iRobotics-Pacbot/Electrical/README.md

View this project on [CADLAB.io](https://cadlab.io/project/28443). 

# Electrical
