iRobotics-Pacbot/Electrical/power2025/MainPCB/Added Parts/NCP167BMX330TBG/NCP167BMX330TBG.step

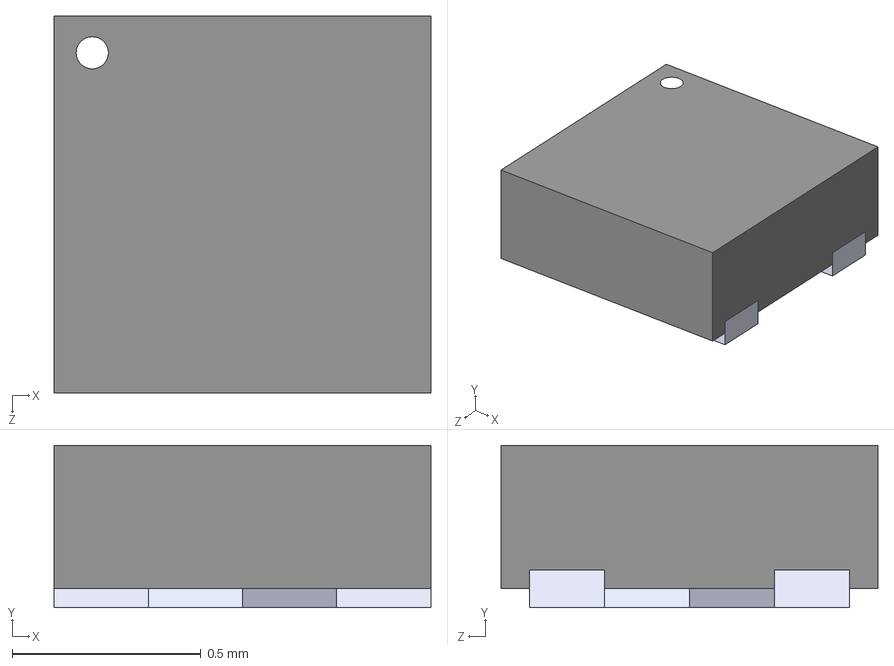
[picture p1: CAD file, 2025-10-03]
power2025/MainPCB/Added Parts/NCP167BMX330TBG/NCP167BMX330TBG.step
1.00 x 0.43 x 1.00 mm
