iRobotics-Pacbot/Electrical/power2025/MainPCB/MainPCB.kicad_pcb

## KiCad design power2025/MainPCB/MainPCB.kicad_pcb (2025-10-12)

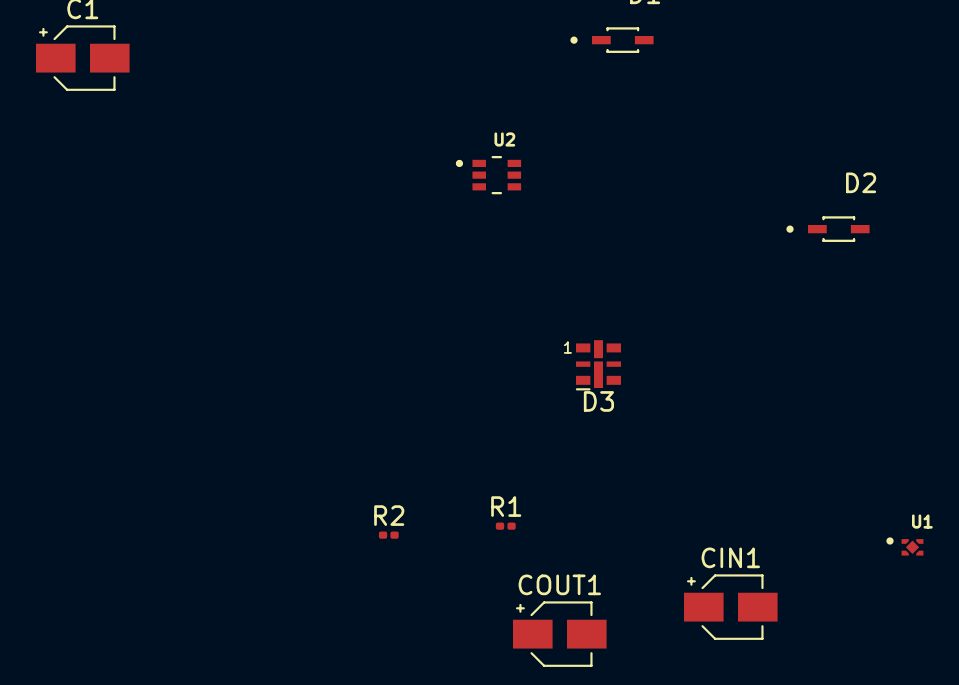
[picture p2: board MainPCB.kicad_pcb from above]

Board: 2 copper layers, 10 parts (0 on the bottom side), 5 nets, no tracks yet.

Parts:
C1: 10uF; CP_Elec_3x5.3
CIN1: 1uF; CP_Elec_3x5.3
COUT1: 1uF; CP_Elec_3x5.3
D1, D2: D_Schottky_Filled; SOD2513X120N
D3: RED; LED-APA102-2020
R1: 100K; R_0201_0603Metric
R2: 3K3; R_0201_0603Metric
U1: NCP167BMX330TBG; VREG_NCP167BMX330TBG
U2: CJ3139K; SOP65P210X110-6N

Connections:
GND: C1.1, CIN1.2, COUT1.2, D3.1 (K), R1.1, U1.2 (GND), U1.5 (EPAD)
unnamed: C1.2, D1.1 (K), D2.2 (A), R1.2, R2.2
unnamed: CIN1.1, D2.1 (K), U1.3 (EN), U1.4 (IN)
unnamed: D3.2 (A), R2.1
unnamed: COUT1.1, U1.1 (OUT)
