iRobotics-Pacbot/Electrical/Pacbot_example/pacbot_example.kicad_pcb

## KiCad design Pacbot_example/pacbot_example.kicad_pcb (2025-09-28)

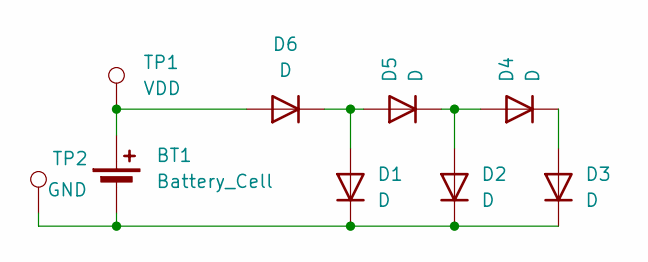
[picture p3: schematic pacbot_example.kicad_sch]

Parts:
BT1: Battery_Cell; BatteryHolder_LINX_BAT-HLD-012-SMT
D1, D2, D3, D4, D5, D6: D; D_0805_2012Metric
TP1: VDD; PinHeader_1x01_P2.54mm_Vertical
TP2: GND; PinHeader_1x01_P2.54mm_Vertical

Connections:
unnamed: BT1.1 (+), D6.2 (A), TP1.1
unnamed: BT1.2 (-), D1.1 (K), D2.1 (K), D3.1 (K), TP2.1
unnamed: D1.2 (A), D5.2 (A), D6.1 (K)
unnamed: D2.2 (A), D4.2 (A), D5.1 (K)
unnamed: D3.2 (A), D4.1 (K)

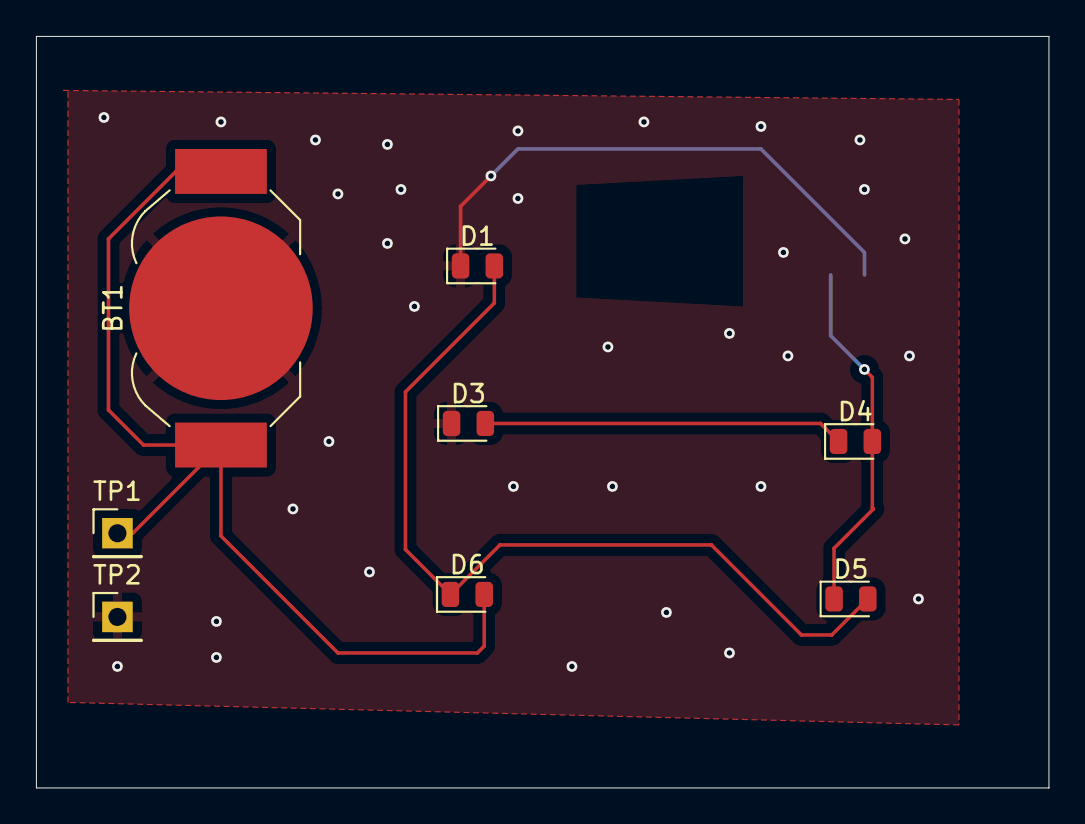
[picture p4: board pacbot_example.kicad_pcb from above]

Board: 2 copper layers, 56.2 x 41.8 mm, 9 parts (1 on the bottom side), 5 nets.
