iRobotics-Pacbot/Electrical/pacboard2025_alt/pacboard2025_alt.kicad_pcb

## KiCad design pacboard2025_alt/pacboard2025_alt.kicad_pcb (2025-02-01)

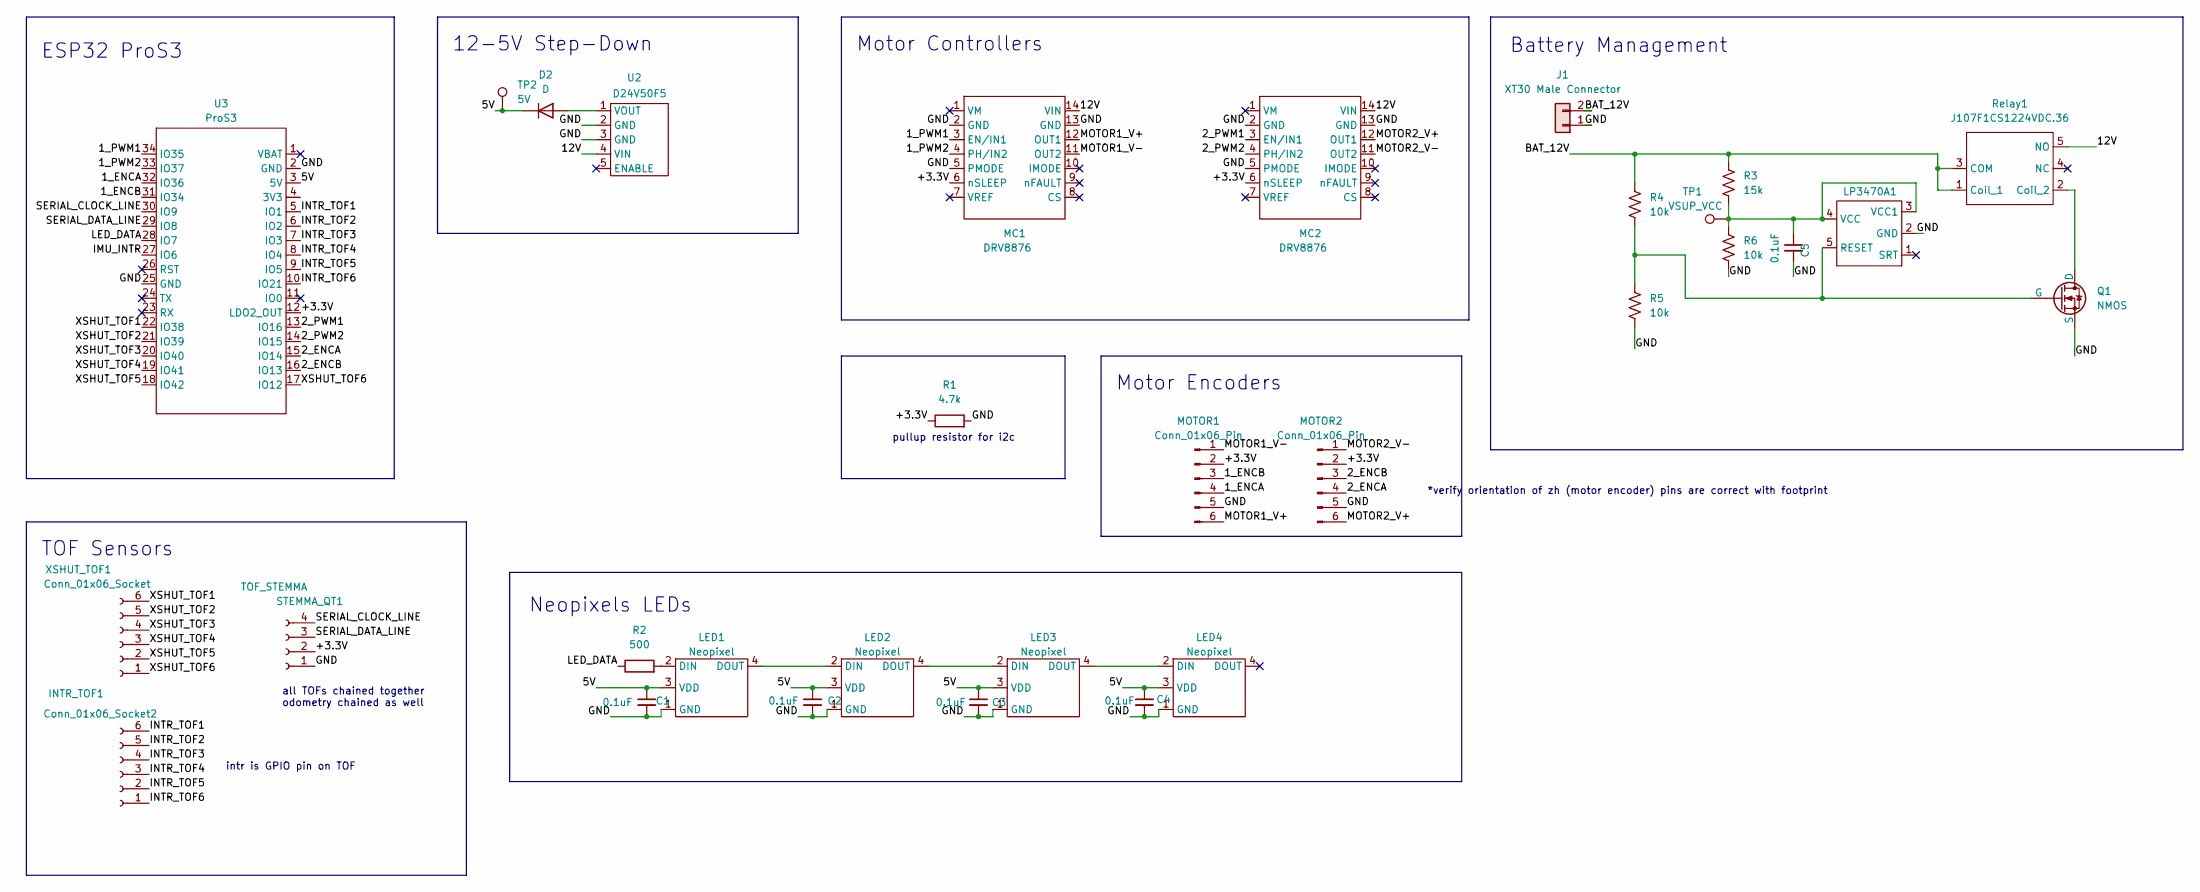
[picture p5: schematic pacboard2025_alt.kicad_sch]

Parts:
C1, C2, C3, C4, C5: 0.1uF; C_0805_2012Metric_Pad1.18x1.45mm_HandSolder
D2: D; D_SMB
INTR_TOF1: Conn_01x06_Socket2; PinHeader_1x06_P2.54mm_Vertical
J1: XT30 Male Connector; AMASS_XT30U-M_1x02_P5.0mm_Vertical
LED1, LED2, LED3, LED4: Neopixel; Neopixels 5050
LP3470A1: SOT-23-5
MC1, MC2: DRV8876
MOTOR1, MOTOR2: Conn_01x06_Pin; ZH1.5-6
Q1: NMOS; SOT-23
R1: 4.7k; R_0805_2012Metric_Pad1.20x1.40mm_HandSolder
R2: 500; R_0805_2012Metric_Pad1.20x1.40mm_HandSolder
R3: 15k; R_0805_2012Metric
R4, R5, R6: 10k; R_0805_2012Metric
Relay1: J107F1CS1224VDC.36; J107
STEMMA_QT1: TOF_STEMMA; JST_SH_SM04B-SRSS-TB_1x04-1MP_P1.00mm_Horizontal
TP1: VSUP_VCC; PinHeader_1x01_P2.54mm_Vertical
TP2: 5V; PinHeader_1x01_P2.54mm_Vertical
U2: D24V50F5; PinHeader_1x05_P2.54mm_Vertical
U3: ProS3; ProS3_TH (1)
XSHUT_TOF1: Conn_01x06_Socket; PinHeader_1x06_P2.54mm_Vertical

Connections:
/1_ENCA: MOTOR1.4, U3.32 (IO36)
/1_ENCB: MOTOR1.3, U3.31 (IO34)
/1_PWM1: MC1.3 (EN/IN1), U3.34 (IO35)
/1_PWM2: MC1.4 (PH/IN2), U3.33 (IO37)
/2_ENCA: MOTOR2.4, U3.15 (IO14)
/2_ENCB: MOTOR2.3, U3.16 (IO13)
/2_PWM1: MC2.3 (EN/IN1), U3.13 (IO16)
/2_PWM2: MC2.4 (PH/IN2), U3.14 (IO15)
/5V: C1.1, C2.1, C3.1, C4.1, D2.1 (K), LED1.3 (VDD), LED2.3 (VDD), LED3.3 (VDD), LED4.3 (VDD), TP2.1, U3.3 (5V)
/12V: MC1.14 (VIN), MC2.14 (VIN), Relay1.5 (NO), U2.4 (VIN)
/+3.3V: MC1.6 (nSLEEP), MC2.6 (nSLEEP), MOTOR1.2, MOTOR2.2, R1.1, STEMMA_QT1.2, U3.12 (LDO2_OUT)
/BAT_12V: J1.2, R3.1, R4.1, Relay1.1 (Coil_1), Relay1.3 (COM)
/GND: C1.2, C2.2, C3.2, C4.2, C5.2, J1.1, LED1.1 (GND), LED2.1 (GND), LED3.1 (GND), LED4.1 (GND), LP3470A1.2 (GND), MC1.2 (GND), MC1.5 (PMODE), MC1.13 (GND), MC2.2 (GND), MC2.5 (PMODE), MC2.13 (GND), MOTOR1.5, MOTOR2.5, Q1.2 (S), R1.2, R5.2, R6.2, STEMMA_QT1.1, U2.2 (GND), U2.3 (GND), U3.2 (GND), U3.25 (GND); also elsewhere on the board
/IMU_INTR: U3.27 (IO6)
/INTR_TOF1: INTR_TOF1.6, U3.5 (IO1)
/INTR_TOF2: INTR_TOF1.5, U3.6 (IO2)
/INTR_TOF3: INTR_TOF1.4, U3.7 (IO3)
/INTR_TOF4: INTR_TOF1.3, U3.8 (IO4)
/INTR_TOF5: INTR_TOF1.2, U3.9 (IO5)
/INTR_TOF6: INTR_TOF1.1, U3.10 (IO21)
/LED_DATA: R2.1, U3.28 (IO7)
/MOTOR1_V+: MC1.12 (OUT1), MOTOR1.6
/MOTOR1_V-: MC1.11 (OUT2), MOTOR1.1
/MOTOR2_V+: MC2.12 (OUT1), MOTOR2.6
/MOTOR2_V-: MC2.11 (OUT2), MOTOR2.1
/SERIAL_CLOCK_LINE: STEMMA_QT1.4, U3.30 (IO9)
/SERIAL_DATA_LINE: STEMMA_QT1.3, U3.29 (IO8)
/XSHUT_TOF1: U3.22 (IO38), XSHUT_TOF1.6
/XSHUT_TOF2: U3.21 (IO39), XSHUT_TOF1.5
/XSHUT_TOF3: U3.20 (IO40), XSHUT_TOF1.4
/XSHUT_TOF4: U3.19 (IO41), XSHUT_TOF1.3
/XSHUT_TOF5: U3.18 (IO42), XSHUT_TOF1.2
/XSHUT_TOF6: U3.17 (IO12), XSHUT_TOF1.1
unnamed: D2.2 (A), U2.1 (VOUT)
unnamed: LED1.2 (DIN), R2.2
unnamed: LED1.4 (DOUT), LED2.2 (DIN)
unnamed: LED2.4 (DOUT), LED3.2 (DIN)
unnamed: LED3.4 (DOUT), LED4.2 (DIN)
unnamed: LP3470A1.5 (RESET), Q1.1 (G), R4.2, R5.1
unnamed: C5.1, LP3470A1.3 (VCC1), LP3470A1.4 (VCC), R3.2, R6.1, TP1.1
unnamed: Q1.3 (D), Relay1.2 (Coil_2)

Notes on the sheet:
ESP32 ProS3
pullup resistor for i2c
intr is GPIO pin on TOF
Motor Encoders
all TOFs chained together odometry chained as well
12-5V Step-Down
Battery Management
*verify orientation of zh (motor encoder) pins are correct with footprint
TOF Sensors
Motor Controllers
Neopixels LEDs

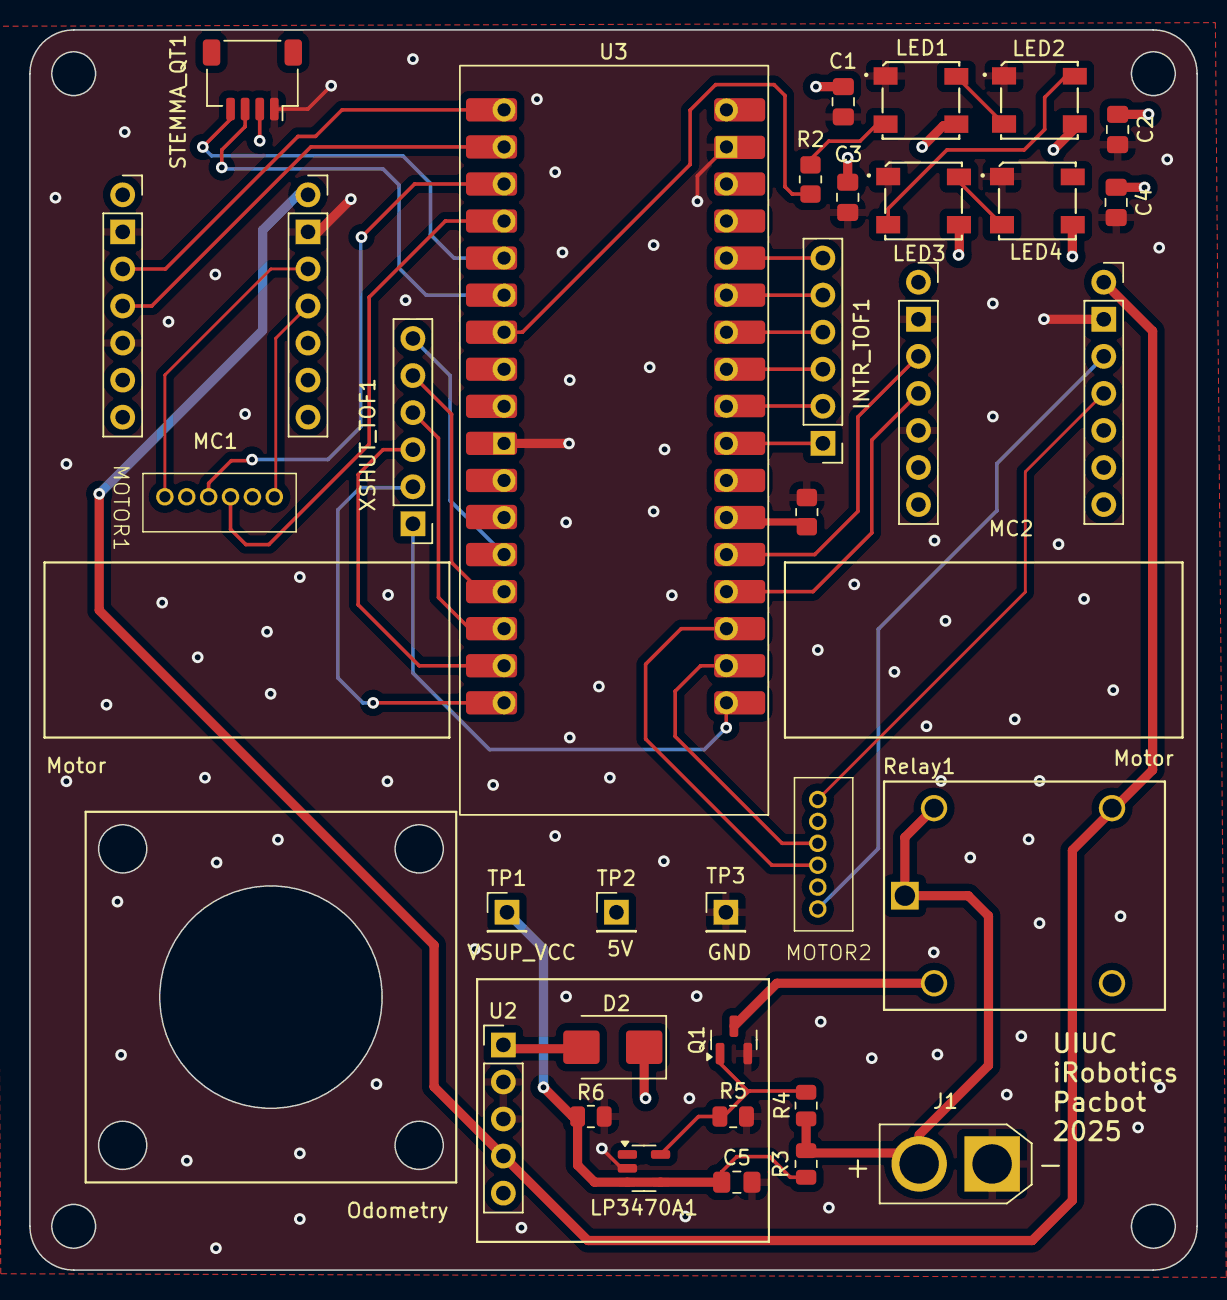
[picture p6: board pacboard2025_alt.kicad_pcb from above]

Board: 4 copper layers, 80.0 x 85.0 mm, 32 parts (0 on the bottom side), 40 nets.

Other parts of the board:
TP3: GND; PinHeader_1x01_P2.54mm_Vertical

Their connections:
/GND: TP3.1; also elsewhere on the board
