iRobotics-Pacbot/Electrical/pacboard2023/board1.kicad_pcb

## KiCad design pacboard2023/board1.kicad_pcb (2024-09-14)

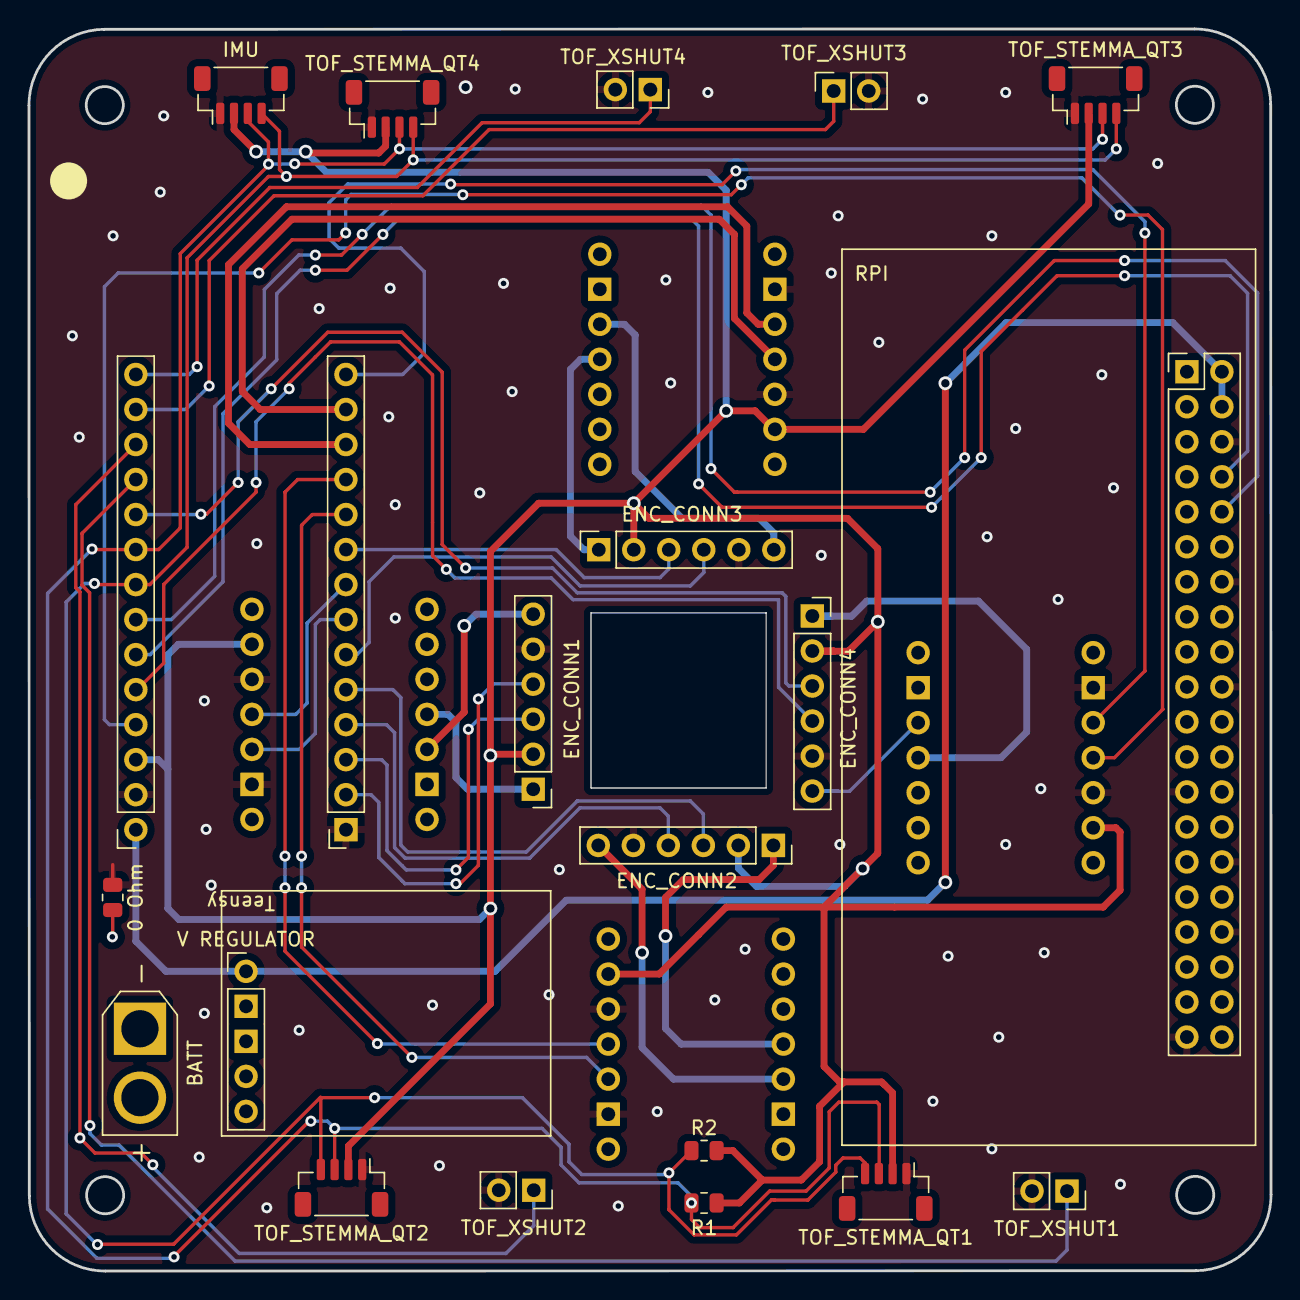
[picture p7: board pacboard2023/board1.kicad_pcb from above]

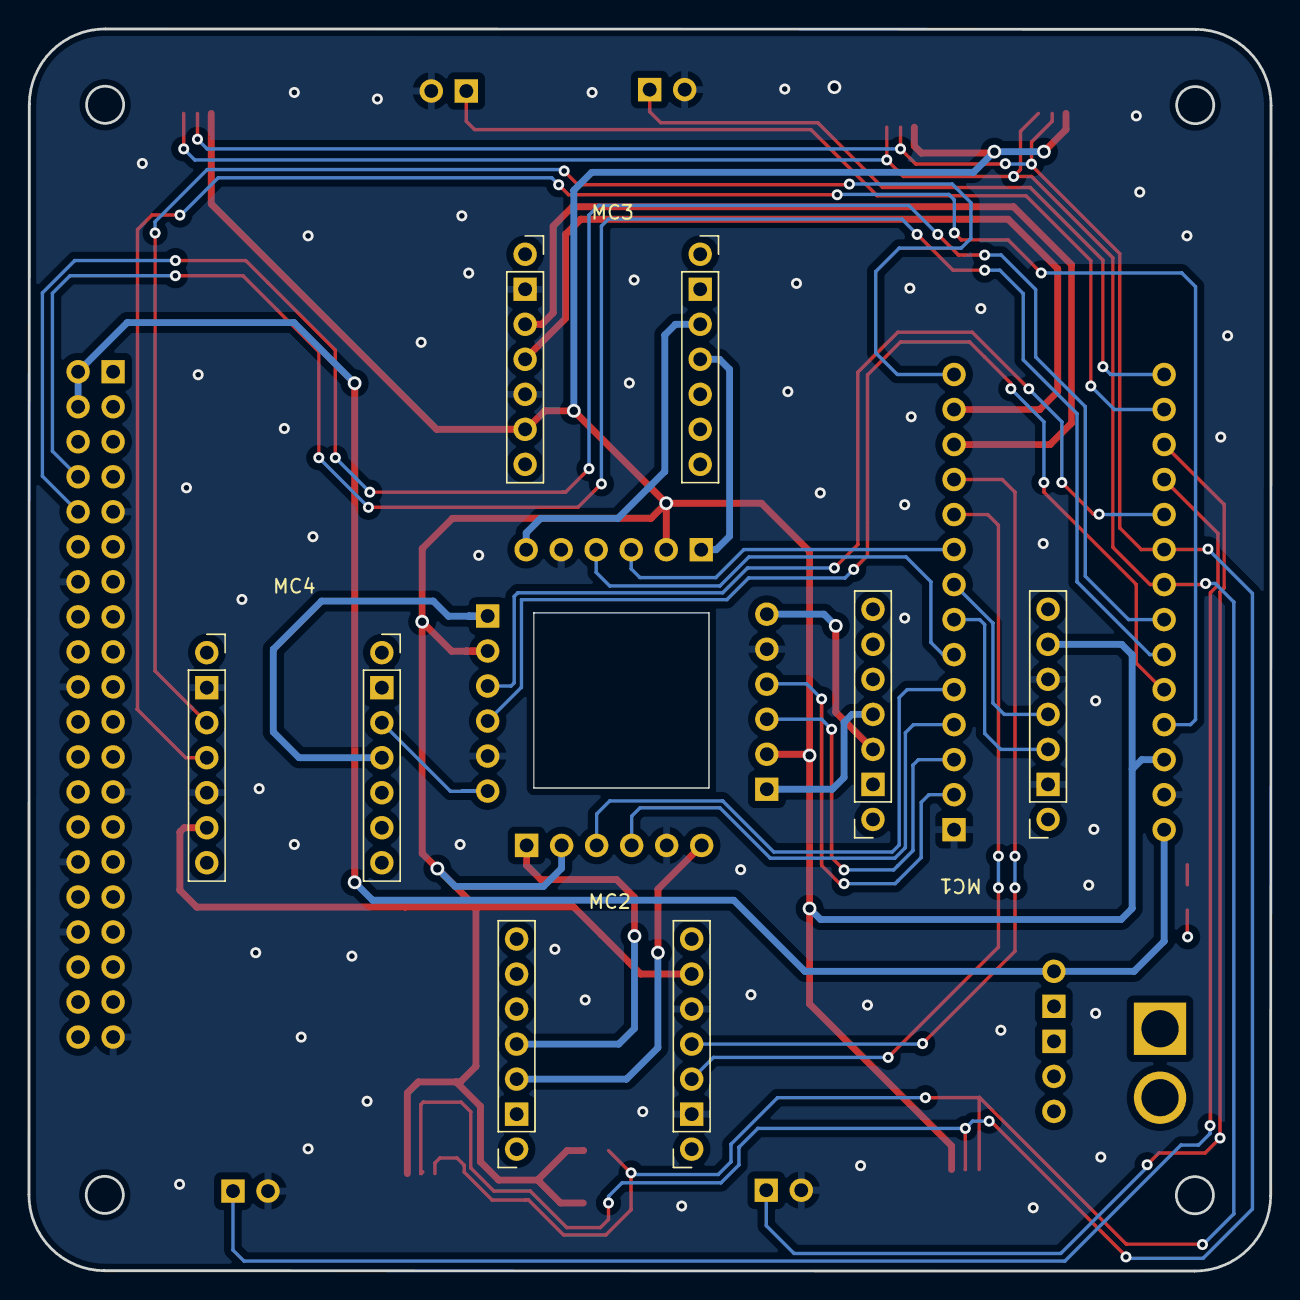
[picture p8: board pacboard2023/board1.kicad_pcb from below]

Board: 4 copper layers, 90.1 x 90.1 mm, 24 parts (4 on the bottom side), 37 nets.

Parts:
0 Ohm: 0 Ohms; R_0805_2012Metric
BATT: XT30 Male Connector; AMASS_XT30U-M_1x02_P5.0mm_Vertical
ENC_CONN1: Conn_01x06_Male; PinHeader_1x06_P2.54mm_Vertical
ENC_CONN2, ENC_CONN3, ENC_CONN4: Conn_01x06_Male; PinSocket_1x06_P2.54mm_Vertical
IMU: BNO085; JST_SH_BM04B-SRSS-TB_1x04-1MP_P1.00mm_Vertical
MC1, MC2, MC3, MC4: DRV8876
R1, R2: 4.7k; R_0805_2012Metric
RPI: Raspberry_PI_Zero_W; Raspberry Pi Zero W
TOF_STEMMA_QT1, TOF_STEMMA_QT2, TOF_STEMMA_QT3, TOF_STEMMA_QT4: Conn_01x04_Female; JST_SH_BM04B-SRSS-TB_1x04-1MP_P1.00mm_Vertical
TOF_XSHUT1, TOF_XSHUT2, TOF_XSHUT3, TOF_XSHUT4: Conn_01x02_Female; PinSocket_1x02_P2.54mm_Vertical
Teensy: Teensy_4.0; Teensy 4.0
V REGULATOR: D24V50F5; Voltage Regulator D24V50F5

Connections:
/3V3_Teensy: ENC_CONN1.2, ENC_CONN2.2, ENC_CONN3.2, ENC_CONN4.2, IMU.2 (VIN), MC1.6 (nSLEEP), MC2.6 (nSLEEP), MC3.6 (nSLEEP), MC4.6 (nSLEEP), R1.2, R2.2, TOF_STEMMA_QT1.2, TOF_STEMMA_QT2.2, TOF_STEMMA_QT3.2, TOF_STEMMA_QT4.2, Teensy.6 (3.3V)
/5V: RPI.2 (5V), RPI.4 (5V), Teensy.2 (Vin), V REGULATOR.1 (VOUT)
/12V: BATT.2, MC1.14 (VIN), MC2.14 (VIN), MC3.14 (VIN), MC4.14 (VIN), V REGULATOR.4 (VIN)
/BATTERY_GROUND: 0 Ohm.2, BATT.1, MC1.13 (GND), MC2.13 (GND), MC3.13 (GND), MC4.13 (GND), V REGULATOR.2 (GND), V REGULATOR.3 (GND)
/ENC_1_PINA: ENC_CONN1.4, Teensy.3 (0)
/ENC_1_PINB: ENC_CONN1.3, Teensy.5 (1)
/ENC_2_PINA: ENC_CONN2.4, Teensy.7 (2)
/ENC_2_PINB: ENC_CONN2.3, Teensy.9 (3)
/ENC_3_PINA: ENC_CONN3.4, Teensy.11 (4)
/ENC_3_PINB: ENC_CONN3.3, Teensy.17 (7)
/ENC_4_PINA: ENC_CONN4.4, Teensy.10 (22)
/ENC_4_PINB: ENC_CONN4.3, Teensy.20 (17)
/MC1_PWM1: MC1.3 (EN/IN1), Teensy.13 (5)
/MC1_PWM2: MC1.4 (PH/IN2), Teensy.15 (6)
/MC2_PWM1: MC2.3 (EN/IN1), Teensy.19 (8)
/MC2_PWM2: MC2.4 (PH/IN2), Teensy.21 (9)
/MC3_PWM1: MC3.3 (EN/IN1), Teensy.23 (10)
/MC3_PWM2: MC3.4 (PH/IN2), Teensy.25 (11)
/MC4_PWM1: MC4.3 (EN/IN1), Teensy.27 (12)
/MC4_PWM2: MC4.4 (PH/IN2), Teensy.8 (23)
/MOTOR_1_PIN1: ENC_CONN1.6, MC1.12 (OUT1)
/MOTOR_1_PIN2: ENC_CONN1.1, MC1.11 (OUT2)
/MOTOR_2_PIN1: ENC_CONN2.6, MC2.12 (OUT1)
/MOTOR_2_PIN2: ENC_CONN2.1, MC2.11 (OUT2)
/MOTOR_3_PIN1: ENC_CONN3.6, MC3.12 (OUT1)
/MOTOR_3_PIN2: ENC_CONN3.1, MC3.11 (OUT2)
/MOTOR_4_PIN1: ENC_CONN4.6, MC4.12 (OUT1)
/MOTOR_4_PIN2: ENC_CONN4.1, MC4.11 (OUT2)
/SCL_LINE: IMU.4 (SCL), R2.1, TOF_STEMMA_QT1.4, TOF_STEMMA_QT2.4, TOF_STEMMA_QT3.4, TOF_STEMMA_QT4.4, Teensy.16 (19)
/SDA_LINE: IMU.3 (SDA), R1.1, TOF_STEMMA_QT1.3, TOF_STEMMA_QT2.3, TOF_STEMMA_QT3.3, TOF_STEMMA_QT4.3, Teensy.18
/TOF_1_XSHUT: TOF_XSHUT1.1, Teensy.22 (16)
/TOF_2_XSHUT: TOF_XSHUT2.1, Teensy.24 (15)
/TOF_3_XSHUT: TOF_XSHUT3.1, Teensy.26 (14)
/TOF_4_XSHUT: TOF_XSHUT4.1, Teensy.28 (13)
/UART RXD (R PI): RPI.10 (GPIO_15_(RXD)), Teensy.14 (20)
/UART TXD (R PI): RPI.8 (GPIO_14_(TXD)), Teensy.12 (21)
GNDREF: 0 Ohm.1, ENC_CONN1.5, ENC_CONN2.5, ENC_CONN3.5, ENC_CONN4.5, IMU.1 (GND), MC1.2 (GND), MC1.5 (PMODE), MC2.2 (GND), MC2.5 (PMODE), MC3.2 (GND), MC3.5 (PMODE), MC4.2 (GND), MC4.5 (PMODE), RPI.6 (GND), RPI.9 (GND), RPI.14 (GND), RPI.20 (GND), RPI.25 (GND), RPI.30 (GND), RPI.34 (GND), RPI.39 (GND), TOF_STEMMA_QT1.1, TOF_STEMMA_QT2.1, TOF_STEMMA_QT3.1, TOF_STEMMA_QT4.1, TOF_XSHUT1.2, TOF_XSHUT2.2, TOF_XSHUT3.2, TOF_XSHUT4.2, Teensy.1 (GND), Teensy.4 (GND)
