iRobotics-Pacbot/Electrical/pacboard2024/board1.kicad_pcb

## KiCad design pacboard2024/board1.kicad_pcb (2024-09-14)

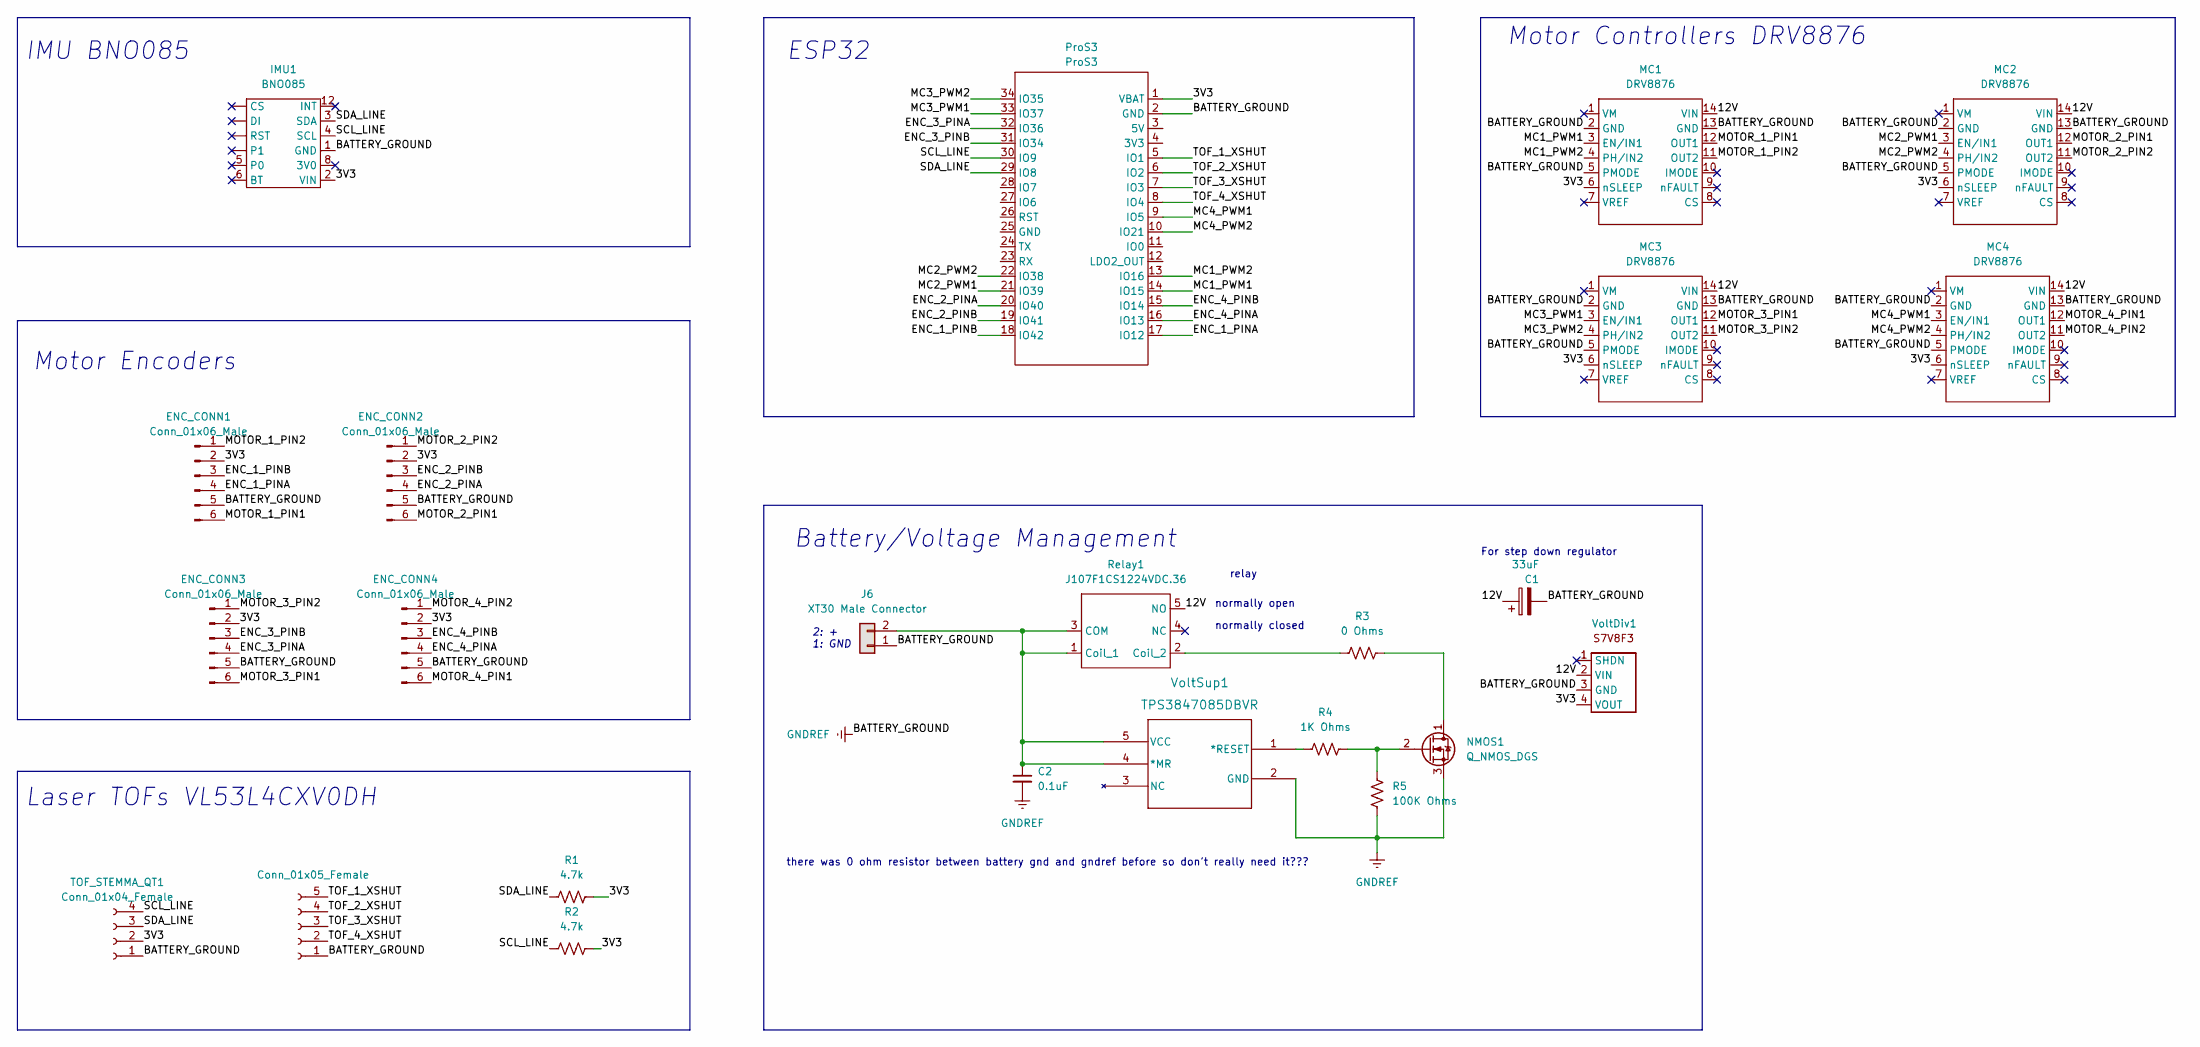
[picture p9: schematic board1.kicad_sch]

Parts:
C1: 33uF; CA45-B-16V-33uF-K
C2: 0.1uF; C_0805_2012Metric_Pad1.18x1.45mm_HandSolder
ENC_CONN1, ENC_CONN2, ENC_CONN3, ENC_CONN4: Conn_01x06_Male; ZH1.5-6
IMU1: BNO085; JST_SH_BM04B-SRSS-TB_1x04-1MP_P1.00mm_Vertical
J1: Conn_01x05_Female; PinSocket_1x05_P2.54mm_Vertical
J6: XT30 Male Connector; AMASS_XT30U-M_1x02_P5.0mm_Vertical
MC1, MC2, MC3, MC4: DRV8876
NMOS1: Q_NMOS_DGS; SOT-23
ProS3: ProS3; ProS3_TH (1)
R1, R2: 4.7k; R_0805_2012Metric
R3: 0 Ohms; R_0805_2012Metric
R4: 1K Ohms; R_0805_2012Metric
R5: 100K Ohms; R_0805_2012Metric
Relay1: J107F1CS1224VDC.36; J107
TOF_STEMMA_QT1: Conn_01x04_Female; JST_SH_BM04B-SRSS-TB_1x04-1MP_P1.00mm_Vertical
VoltDiv1: S7V8F3
VoltSup1: TPS3847085DBVR; DBV5_TEX

Connections:
/3V3: ENC_CONN1.2, ENC_CONN2.2, ENC_CONN3.2, ENC_CONN4.2, IMU1.2 (VIN), MC1.6 (nSLEEP), MC2.6 (nSLEEP), MC3.6 (nSLEEP), MC4.6 (nSLEEP), ProS3.1 (VBAT), R1.2, R2.2, TOF_STEMMA_QT1.2, VoltDiv1.4 (VOUT)
/12V: C1.1, MC1.14 (VIN), MC2.14 (VIN), MC3.14 (VIN), MC4.14 (VIN), Relay1.5 (NO), VoltDiv1.2 (VIN)
/ENC_1_PINA: ENC_CONN1.4, ProS3.17 (IO12)
/ENC_1_PINB: ENC_CONN1.3, ProS3.18 (IO42)
/ENC_2_PINA: ENC_CONN2.4, ProS3.20 (IO40)
/ENC_2_PINB: ENC_CONN2.3, ProS3.19 (IO41)
/ENC_3_PINA: ENC_CONN3.4, ProS3.32 (IO36)
/ENC_3_PINB: ENC_CONN3.3, ProS3.31 (IO34)
/ENC_4_PINA: ENC_CONN4.4, ProS3.16 (IO13)
/ENC_4_PINB: ENC_CONN4.3, ProS3.15 (IO14)
/MC1_PWM1: MC1.3 (EN/IN1), ProS3.14 (IO15)
/MC1_PWM2: MC1.4 (PH/IN2), ProS3.13 (IO16)
/MC2_PWM1: MC2.3 (EN/IN1), ProS3.21 (IO39)
/MC2_PWM2: MC2.4 (PH/IN2), ProS3.22 (IO38)
/MC3_PWM1: MC3.3 (EN/IN1), ProS3.33 (IO37)
/MC3_PWM2: MC3.4 (PH/IN2), ProS3.34 (IO35)
/MC4_PWM1: MC4.3 (EN/IN1), ProS3.9 (IO5)
/MC4_PWM2: MC4.4 (PH/IN2), ProS3.10 (IO21)
/MOTOR_1_PIN1: ENC_CONN1.6, MC1.12 (OUT1)
/MOTOR_1_PIN2: ENC_CONN1.1, MC1.11 (OUT2)
/MOTOR_2_PIN1: ENC_CONN2.6, MC2.12 (OUT1)
/MOTOR_2_PIN2: ENC_CONN2.1, MC2.11 (OUT2)
/MOTOR_3_PIN1: ENC_CONN3.6, MC3.12 (OUT1)
/MOTOR_3_PIN2: ENC_CONN3.1, MC3.11 (OUT2)
/MOTOR_4_PIN1: ENC_CONN4.6, MC4.12 (OUT1)
/MOTOR_4_PIN2: ENC_CONN4.1, MC4.11 (OUT2)
/SCL_LINE: IMU1.4 (SCL), ProS3.30 (IO9), R2.1, TOF_STEMMA_QT1.4
/SDA_LINE: IMU1.3 (SDA), ProS3.29 (IO8), R1.1, TOF_STEMMA_QT1.3
/TOF_1_XSHUT: J1.5, ProS3.5 (IO1)
/TOF_2_XSHUT: J1.4, ProS3.6 (IO2)
/TOF_3_XSHUT: J1.3, ProS3.7 (IO3)
/TOF_4_XSHUT: J1.2, ProS3.8 (IO4)
GNDREF: C1.2, C2.2, ENC_CONN1.5, ENC_CONN2.5, ENC_CONN3.5, ENC_CONN4.5, IMU1.1 (GND), J1.1, J6.1, MC1.2 (GND), MC1.5 (PMODE), MC1.13 (GND), MC2.2 (GND), MC2.5 (PMODE), MC2.13 (GND), MC3.2 (GND), MC3.5 (PMODE), MC3.13 (GND), MC4.2 (GND), MC4.5 (PMODE), MC4.13 (GND), NMOS1.3 (S), ProS3.2 (GND), R5.1, TOF_STEMMA_QT1.1, VoltDiv1.3 (GND), VoltSup1.2 (GND)
unnamed: C2.1, J6.2, Relay1.1 (Coil_1), Relay1.3 (COM), VoltSup1.4 (*MR), VoltSup1.5 (VCC)
unnamed: NMOS1.1 (D), R3.1
unnamed: NMOS1.2 (G), R4.2, R5.2
unnamed: R3.2, Relay1.2 (Coil_2)
unnamed: R4.1, VoltSup1.1 (*RESET)

Notes on the sheet:
Laser TOFs VL53L4CXV0DH
2: + 1: GND
For step down regulator
normally open
there was 0 ohm resistor between battery gnd and gndref before so don't really need it???
Motor Controllers DRV8876
Motor Encoders
relay
ESP32
normally closed
IMU BNO085
Battery/Voltage Management

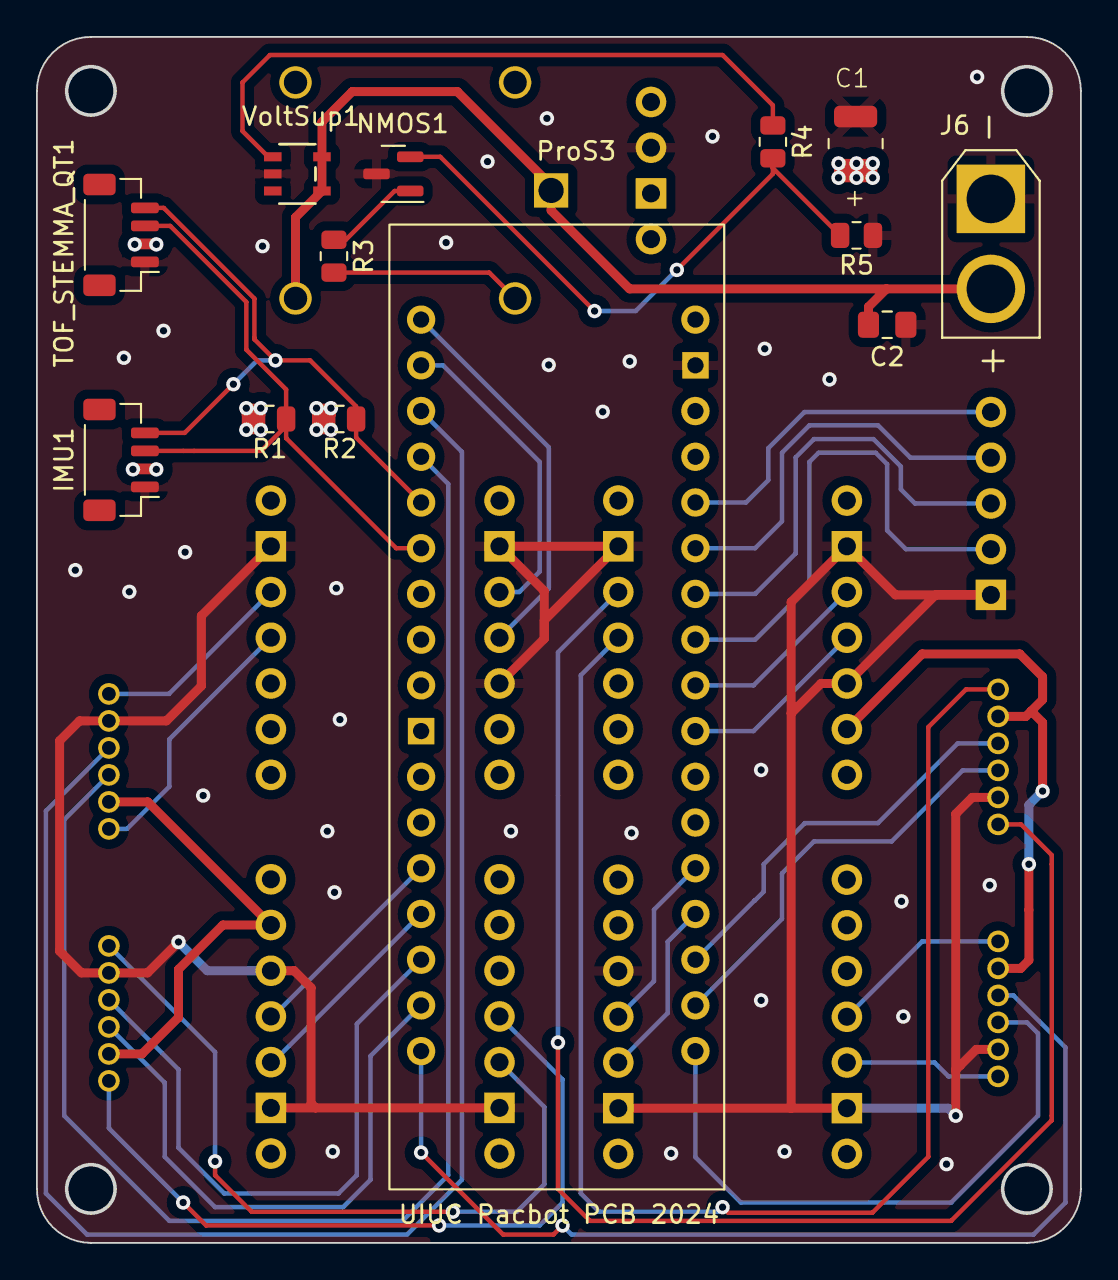
[picture p10: board pacboard2024/board1.kicad_pcb from above]

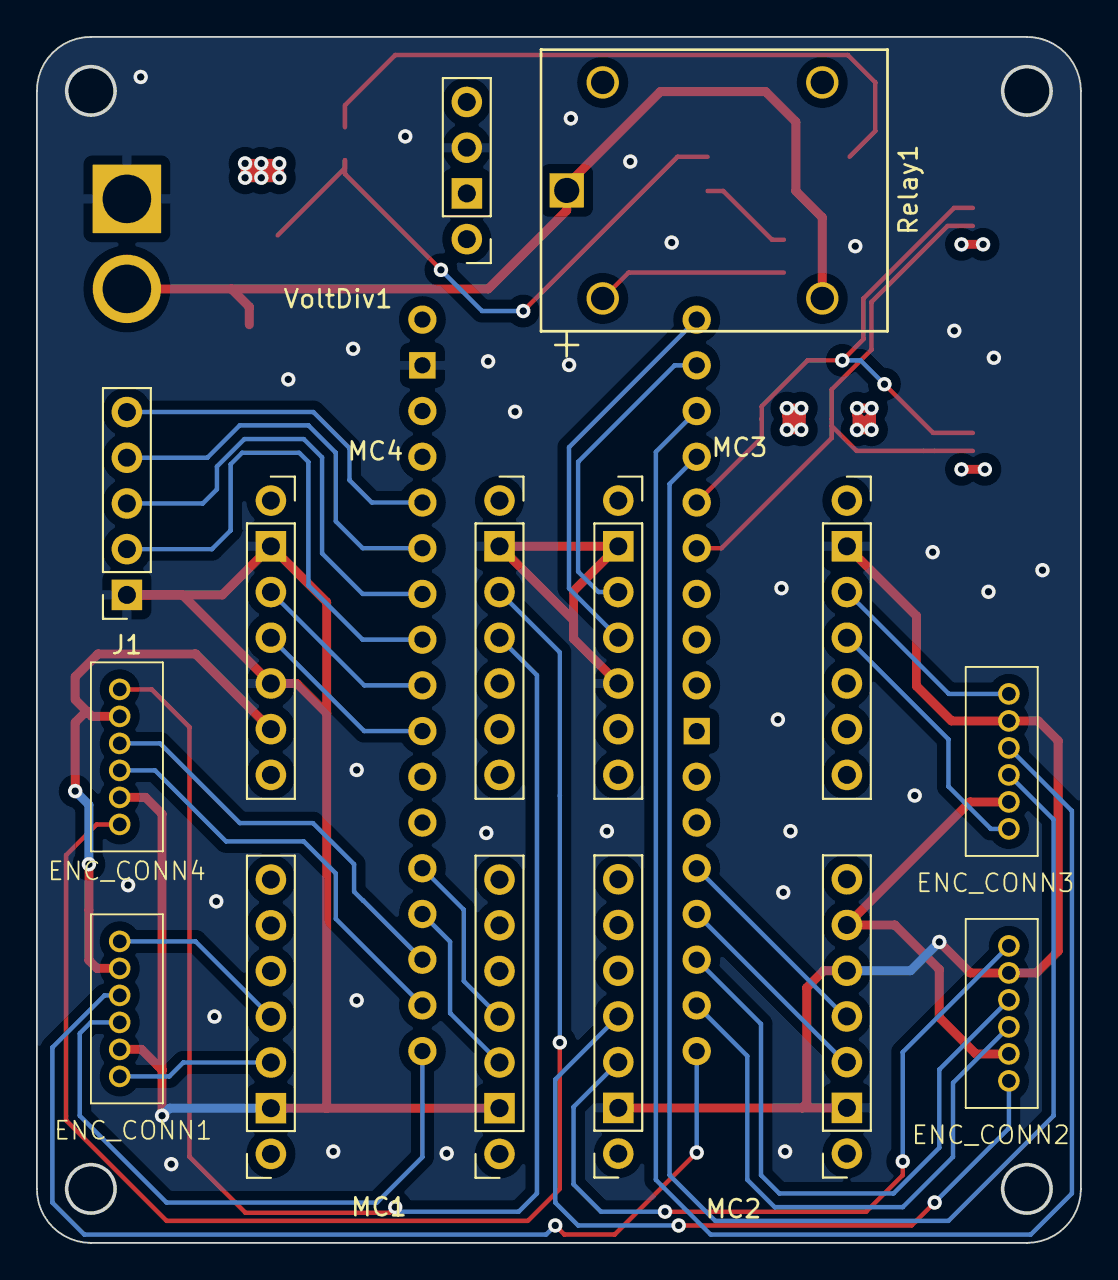
[picture p11: board pacboard2024/board1.kicad_pcb from below]

Board: 4 copper layers, 58.0 x 67.0 mm, 24 parts (11 on the bottom side), 38 nets.
