iRobotics-Pacbot/Electrical/cv_lighting_pcb/cv_lighting_pcb.kicad_pcb

## KiCad design cv_lighting_pcb/cv_lighting_pcb.kicad_pcb (2024-01-21)

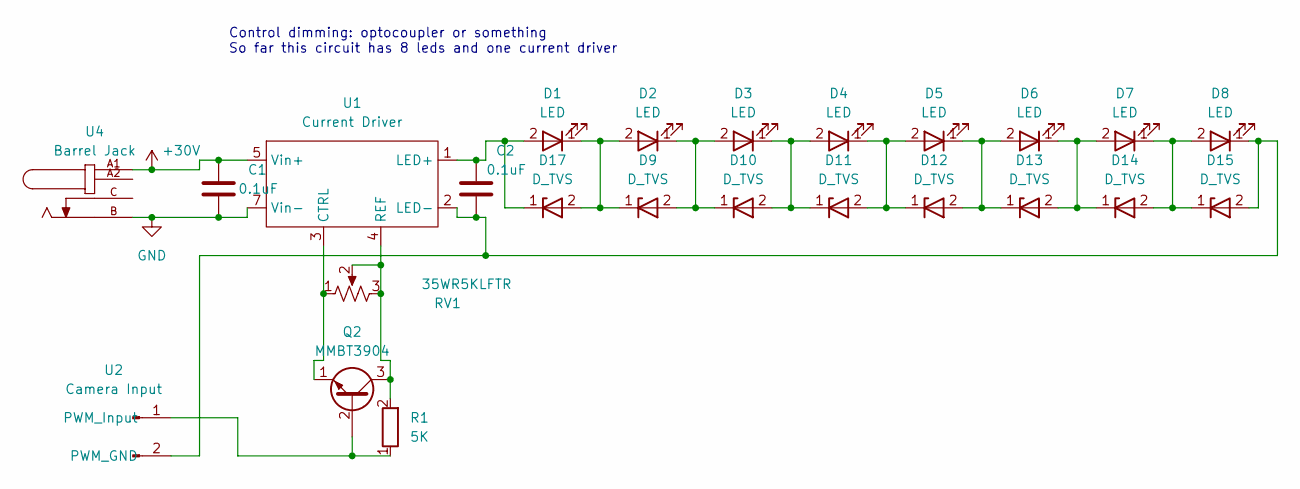
[picture p12: schematic cv_lighting_pcb.kicad_sch, Lighting PCB]

Parts:
C1, C2: 0.1uF; C_0805_2012Metric_Pad1.18x1.45mm_HandSolder
D1, D2, D3, D4, D5, D6, D7, D8: LED; LED_SFH4715AS
D9, D10, D11, D12, D13, D14, D15, D17: D_TVS; D3V3M1U2S9-7
Q2: MMBT3904
R1: 5K; R_0805_2012Metric_Pad1.20x1.40mm_HandSolder
RV1: 35WR5KLFTR
U1: Current Driver; 3021_Buckpuck
U2: Camera Input; PinSocket_1x02_P2.54mm_Vertical_SMD_Pin1Left
U4: Barrel Jack; TENSILITY_54-00164

Connections:
+30V: C1.1, U1.5 (Vin+), U4.A1
GND: C1.2, U1.7 (Vin-), U4.B
unnamed: C2.1, D1.2 (A), D17.1 (K), U1.1 (LED+)
unnamed: D1.1 (K), D2.2 (A), D9.1 (K), D17.2 (A)
unnamed: D3.1 (K), D4.2 (A), D10.2 (A), D11.1 (K)
unnamed: D2.1 (K), D3.2 (A), D9.2 (A), D10.1 (K)
unnamed: D4.1 (K), D5.2 (A), D11.2 (A), D12.1 (K)
unnamed: D5.1 (K), D6.2 (A), D12.2 (A), D13.1 (K)
unnamed: D6.1 (K), D7.2 (A), D13.2 (A), D14.1 (K)
unnamed: D7.1 (K), D8.2 (A), D14.2 (A), D15.1 (K)
unnamed: C2.2, D8.1 (K), D15.2 (A), U1.2 (LED-), U2.2 (PWM_GND)
unnamed: Q2.2 (B), R1.1, U2.1 (PWM_Input)
unnamed: Q2.3 (C), R1.2, RV1.2, RV1.3, U1.4 (REF)
unnamed: Q2.1 (E), RV1.1, U1.3 (CTRL)

Notes on the sheet:
Control dimming: optocoupler or something So far this circuit has 8 leds and one current driver
