iRobotics-Pacbot/Electrical/cv_lighting_pcb/cv_lighting_pcb.kicad_pcb

## KiCad design cv_lighting_pcb/cv_lighting_pcb.kicad_pcb (continued)

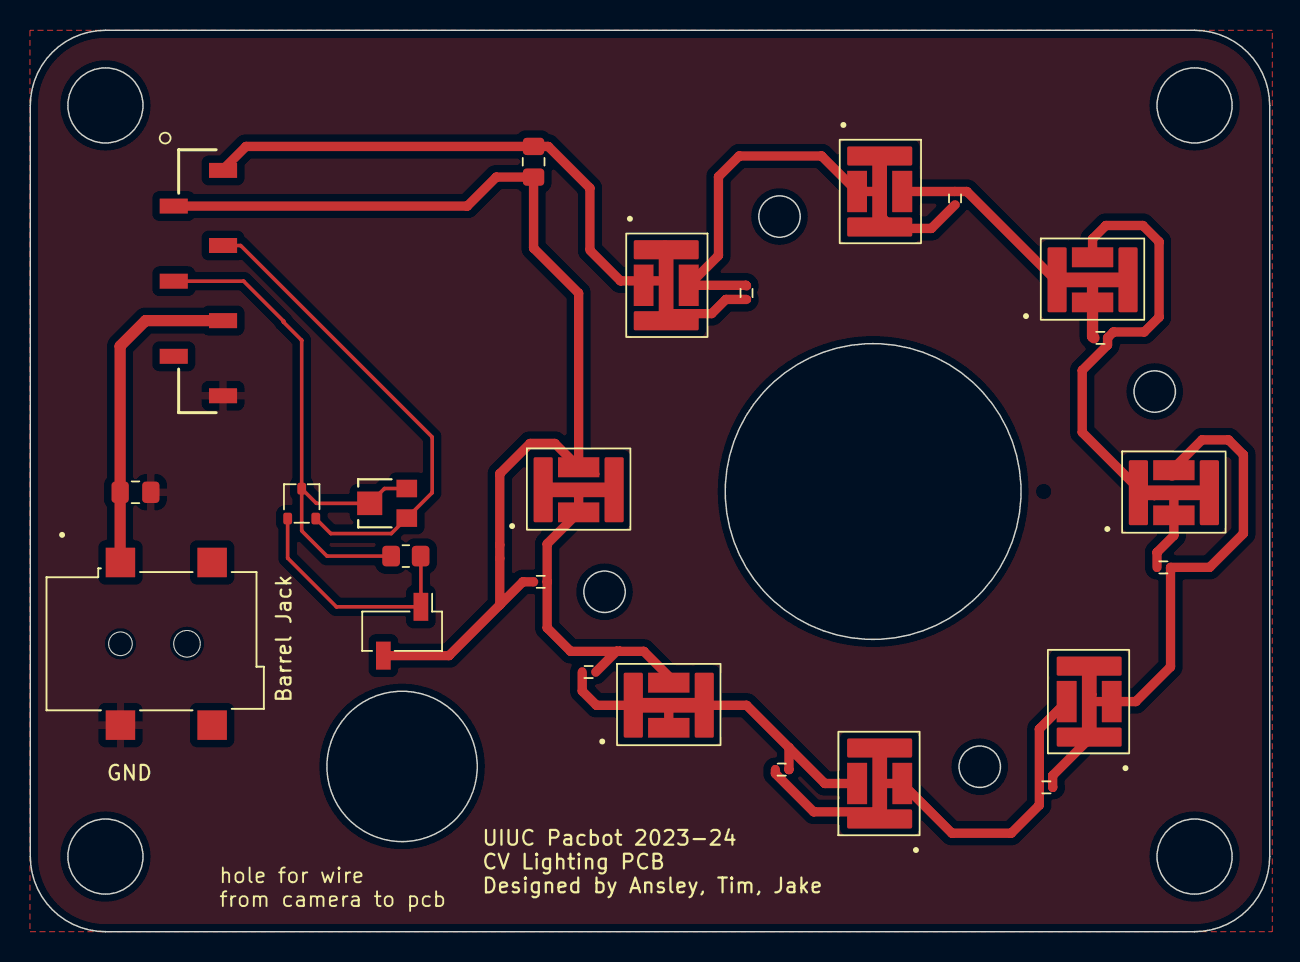
[picture p13: board cv_lighting_pcb.kicad_pcb from above]

Board: 2 copper layers, 83.8 x 61.0 mm, 24 parts (0 on the bottom side), 14 nets.
