iRobotics-Pacbot/Electrical/(commit log)

2023-11-19 start making lighting pcb schematic
    [cv_lighting_pcb.kicad_pcb, cv_lighting_pcb.kicad_sch]
2023-11-22 cv lighting schematic
    [cv_lighting_pcb.kicad_sch]
2023-11-22 formatting changes
    [cv_lighting_pcb.kicad_sch]
2023-12-01 cv lighting schematic almost done, footprints all there
    [cv_lighting_pcb.kicad_pcb, cv_lighting_pcb.kicad_sch]
2023-12-01 added some notes to schematic
    [cv_lighting_pcb.kicad_pcb, cv_lighting_pcb.kicad_sch]
2023-12-03 Added some changes
    [cv_lighting_pcb.kicad_pcb, cv_lighting_pcb.kicad_sch]
2023-12-04 updates to lighting pcb
    [cv_lighting_pcb.kicad_pcb]
2023-12-07 initial routing and edge cuts for pcb
    [cv_lighting_pcb.kicad_pcb]
2023-12-11 updates to lighting pcb, now smaller
    [cv_lighting_pcb.kicad_pcb]
2023-12-11 changes to lighting pcb
    [cv_lighting_pcb.kicad_pcb]
2023-12-18 modified leds a bit
2023-12-19 modified leds a bit more
2024-01-04 more changes to lighting pcb
    [cv_lighting_pcb.kicad_pcb]
2024-01-16 more changes to cv lighting
    [cv_lighting_pcb.kicad_pcb]
2024-01-16 changes to cv lighting
    [cv_lighting_pcb.kicad_sch]
2024-01-17 more changes to cv lighting for like the 100th time
    [cv_lighting_pcb.kicad_pcb]
2024-01-18 cv lighting final?
    [cv_lighting_pcb.kicad_pcb]
2024-01-19 [Generated Gerber Files and Drill Files]
    [cv_lighting_pcb-Edge_Cuts.gbr, cv_lighting_pcb-Edge_Cuts.gm1, cv_lighting_pcb-F_Cu.gbr, cv_lighting_pcb-F_Cu.gtl, cv_lighting_pcb-F_Mask.gbr, cv_lighting_pcb-F_Mask.gts, cv_lighting_pcb-F_Paste.gbr, cv_lighting_pcb-F_Paste.gtp]
2024-01-21 [BOM files are really boom]
    [cv_lighting_pcb.csv]
2024-01-21 added ordering pcb files
    [bom.csv, cv_lighting_pcb.kicad_pcb, cv_lighting_pcb.kicad_sch, designators.csv, positions.csv]
2024-01-22 leftover things not committed; pcb ordered!
    [bom.csv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]
2024-09-14 updating electrical 2023-2024 repository with cv lighting and pacbot pcb
    [board1.kicad_pcb, board1.kicad_sch, board1bom.csv, bom.csv, designators.csv, pacbot_pcb.kicad_pcb, pacbot_pcb.kicad_sch, positions.csv]
2024-09-14 adding 2023 pacbot pcb
    [Top Board.kicad_pcb, Top Board.kicad_sch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]
2024-09-16 making new kicad project
    [pacboard2025.kicad_pcb, pacboard2025.kicad_sch]
2024-09-16 Create new power management circuit folder
2024-09-23 KiCad PCB Attempt
    [pacboard2025.kicad_sch]
2024-10-05 Changed motor controller schematic
    [pacboard2025.kicad_sch]
2024-10-26 PCB design
2024-10-26 some changes to pcb
    [pacboard2025.kicad_pcb, pacboard2025.kicad_sch]
2024-11-08 Changed layout to account for battery and motors, tried routing stuff
    [pacboard2025.kicad_pcb, pacboard2025.kicad_sch]
2024-11-12 new chassis shape
    [pacboard2025.kicad_pcb]
2024-11-16 changed PCB dimensions
    [pacboard2025.kicad_pcb]
2024-11-16 changed motor dimensions
    [pacboard2025.kicad_pcb]
2024-11-16 changed layout
    [pacboard2025.kicad_pcb, pacboard2025.kicad_sch]
2024-11-19 layout updated
    [pacboard2025.kicad_pcb, pacboard2025.kicad_sch]
2024-11-21 updated pcb layout, pros3 has pads
    [pacboard2025.kicad_pcb]
2025-01-09 PCB with routing
    [pacboard2025.kicad_pcb, pacboard2025.kicad_sch]
2025-01-14 added testpoints
    [pacboard2025.kicad_pcb, pacboard2025.kicad_sch]
2025-01-25 some more changes
    [pacboard2025.kicad_pcb, pacboard2025.kicad_sch]
2025-01-26 fixed neopixels, all ready to go?
    [pacboard2025.kicad_pcb, pacboard2025.kicad_sch]
2025-01-26 some minor changes to traces
    [pacboard2025.kicad_pcb]
2025-01-26 some more minor adjustments
    [pacboard2025.kicad_pcb]
2025-01-26 some more misc changes
    [pacboard2025.kicad_pcb, pacboard2025.kicad_sch]
2025-01-26 some more tiny changes
    [pacboard2025.kicad_pcb]
2025-01-28 jonathan change bms
    [bom.csv, designators.csv, pacboard2025.kicad_pcb, pacboard2025.kicad_sch, positions.csv]
2025-01-28 updated bms schematic and layout
    [pacboard2025.kicad_pcb, pacboard2025.kicad_sch]
2025-01-28 final changes, pcb ordered
    [bom.csv, designators.csv, pacboard2025.kicad_pcb, pacboard2025.kicad_sch, positions.csv]
2025-02-01 new bms design
    [bom.csv, designators.csv, pacboard2025_alt.kicad_pcb, pacboard2025_alt.kicad_sch, positions.csv]
2025-09-28 adding example pcb project
    [pacbot_example.kicad_pcb, pacbot_example.kicad_sch]
2025-10-03 Created MainPCB
    [MainPCB.kicad_pcb, MainPCB.kicad_sch, NCP167BMX330TBG.step]
2025-10-03 Created symbol for CJ3139K mosfet
    [MainPCB.kicad_sch]
2025-10-05 Added specific values for in/out capacitors
    [MainPCB.kicad_sch]
2025-10-12 Added footprints
    [MainPCB.kicad_pcb, MainPCB.kicad_sch]
